piranut-op/SCARA_ws/src/scara_robot/meshes/Link_ee.STL

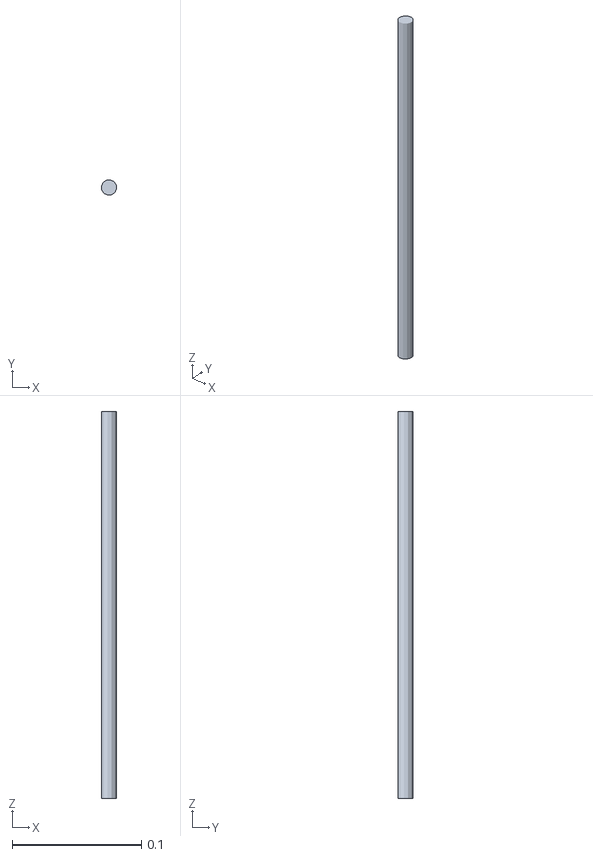
[picture p1: CAD file, 2026-05-05]
src/scara_robot/meshes/Link_ee.STL
0.0118 x 0.0118 x 0.3
