piranut-op/SCARA_ws/src/scara_robot/meshes/Link_2.STL

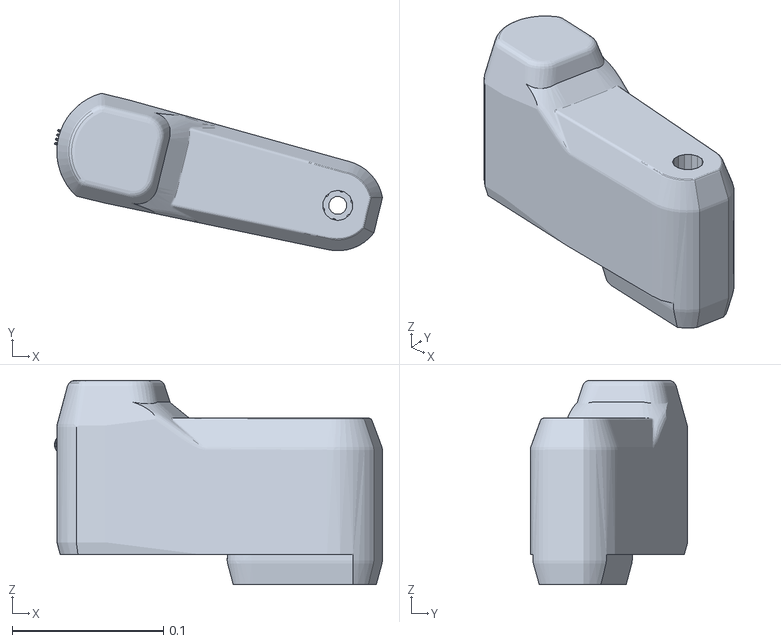
[picture p2: CAD file, 2026-05-05]
src/scara_robot/meshes/Link_2.STL
0.217 x 0.104 x 0.135
