piranut-op/SCARA_ws/src/scara_robot/meshes/Link_1.STL

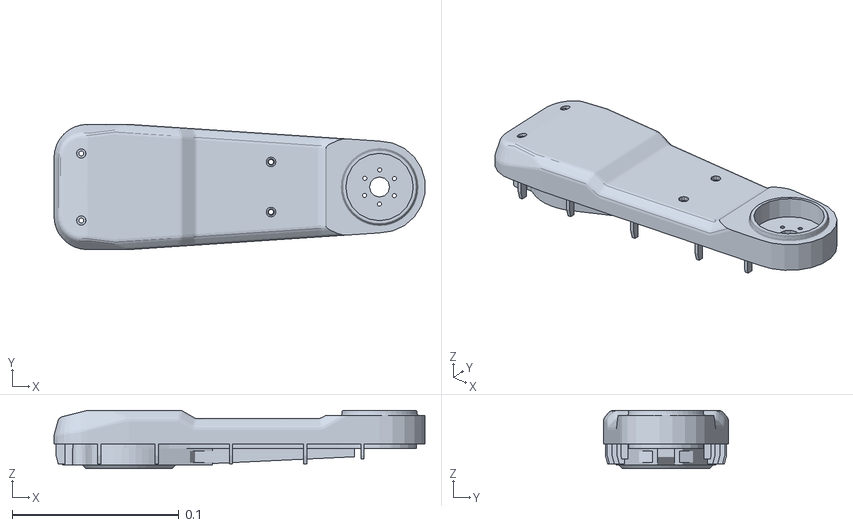
[picture p3: CAD file, 2026-05-05]
src/scara_robot/meshes/Link_1.STL
0.222 x 0.075 x 0.0349
