piranut-op/SCARA_ws/src/scara_robot/meshes/base_link.STL

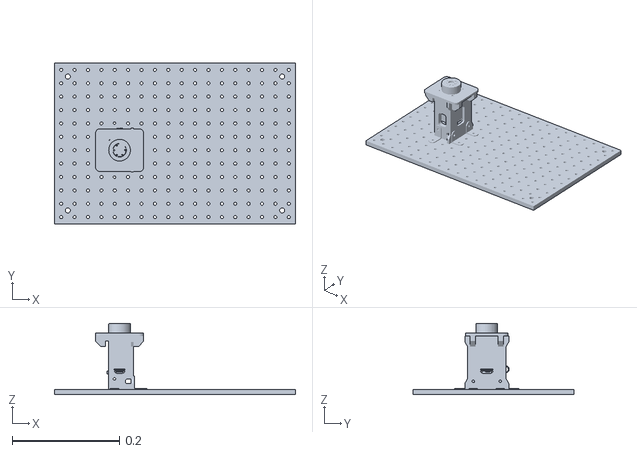
[picture p4: CAD file, 2026-05-05]
src/scara_robot/meshes/base_link.STL
0.45 x 0.3 x 0.133
