piranut-op/SCARA_ws/(commit log)

2026-05-05 Initial commit: SCARA workspace with camera-driven pick-and-place
    - scara_robot: URDF/Xacro robot description, RViz/Gazebo launches
    - scara_moveit_config: MoveIt 2 configuration
    - SCARA_pkg: hardware bridges (ODrive + MKS CAN), IK/FK, RealSense+YOLO
    bottle-cap detector, cap_to_target servo bridge, and pick_and_place_cam
    state machine driving a one-launch camera pick-and-place pipeline
    [Link_1.STL, Link_2.STL, Link_ee.STL, arm.xacro, base_link.STL, joint_limits.yaml, ros2_controllers.yaml, scara_controller.yaml]
2026-05-05 modified solver of camera for pick and place
2026-05-06 modified camera approach
2026-05-12 docs: add workspace-wide project summary
    SCARA_project_summary.md now covers every approach in the workspace
    (RViz, Gazebo, MoveIt demo, hardware bring-up, legacy IK/FK demo,
    move/pick_and_place C++ demos, perception_to_ik tracker, and both
    camera pick-and-place variants), the full calibration story, CAN
    protocol details, and a tuned-defaults reference.
2026-06-17 Camera pick-and-place: calibration + screw-cycle + named home
    URDF / SRDF
    - arm.xacro: correct Link_1_joint origin to (0,0,0.16) — fixes ~5 cm
    Cartesian error traced to the CAD-exported value.
    - scara_robot.srdf: add named states "home" (zeros) and "begin_cam_pick"
    (90° CW Link_1, 90° CCW Link_2) — camera-clearance pose used between
    cycles.
    C++ camera node (cam_pick_and_place.cpp)
    - Plumb joint1_offset_turns / joint2_offset_turns through to the
    hardware bridges to compensate for Link_1 gearbox backlash.
    - Drop ee_joint from setJointValueTarget; route screw motion via the
    new /mks/ee_relative_counts topic so planar joints stay isolated.
    - Approach/engage/retreat state machine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
    [arm.xacro]
2026-06-17 fixed hardcoded model path
    [detect_bottle_cap.py]
